mesutkilic/bitirme1/README.md

GTÜ Bitirme Çalışması II

R-Ø TARAYICI İLE BİLGİSAYAR KONTROLLÜ HALKA ANTEN RADYASYON PATERNİ ÖLÇÜM DÜZENEĞİ GELİŞTİRİLMESİ

Bu projede Labview Kodlarını Bulabilirsiniz.

R-Ø Tarayıcıyı sürmek için RAMPS1.4 Kit ve yazılım olarak Marlin Firmware kullanılmıştır.

Mesut KILIÇ

https://mesutkilic.com.tr
