mesutkilic/bitirme1/(notices)

Notices in the files:
Marlin/Configuration.h:
Copyright (C) 2016 MarlinFirmware [https://github.com/MarlinFirmware/Marlin]
Copyright (C) 2011 Camiel Gubbels / Erik van der Zalm
This program is free software: you can redistribute it and/or modify
it under the terms of the GNU General Public License as published by
the Free Software Foundation, either version 3 of the License, or
(at your option) any later version.
